zzvladyzz/Karane_SeguidorSinTurbina/Karane_Kicad/Seguidor_de_linea.kicad_pcb

## KiCad design Karane_Kicad/Seguidor_de_linea.kicad_pcb (2026-04-10)

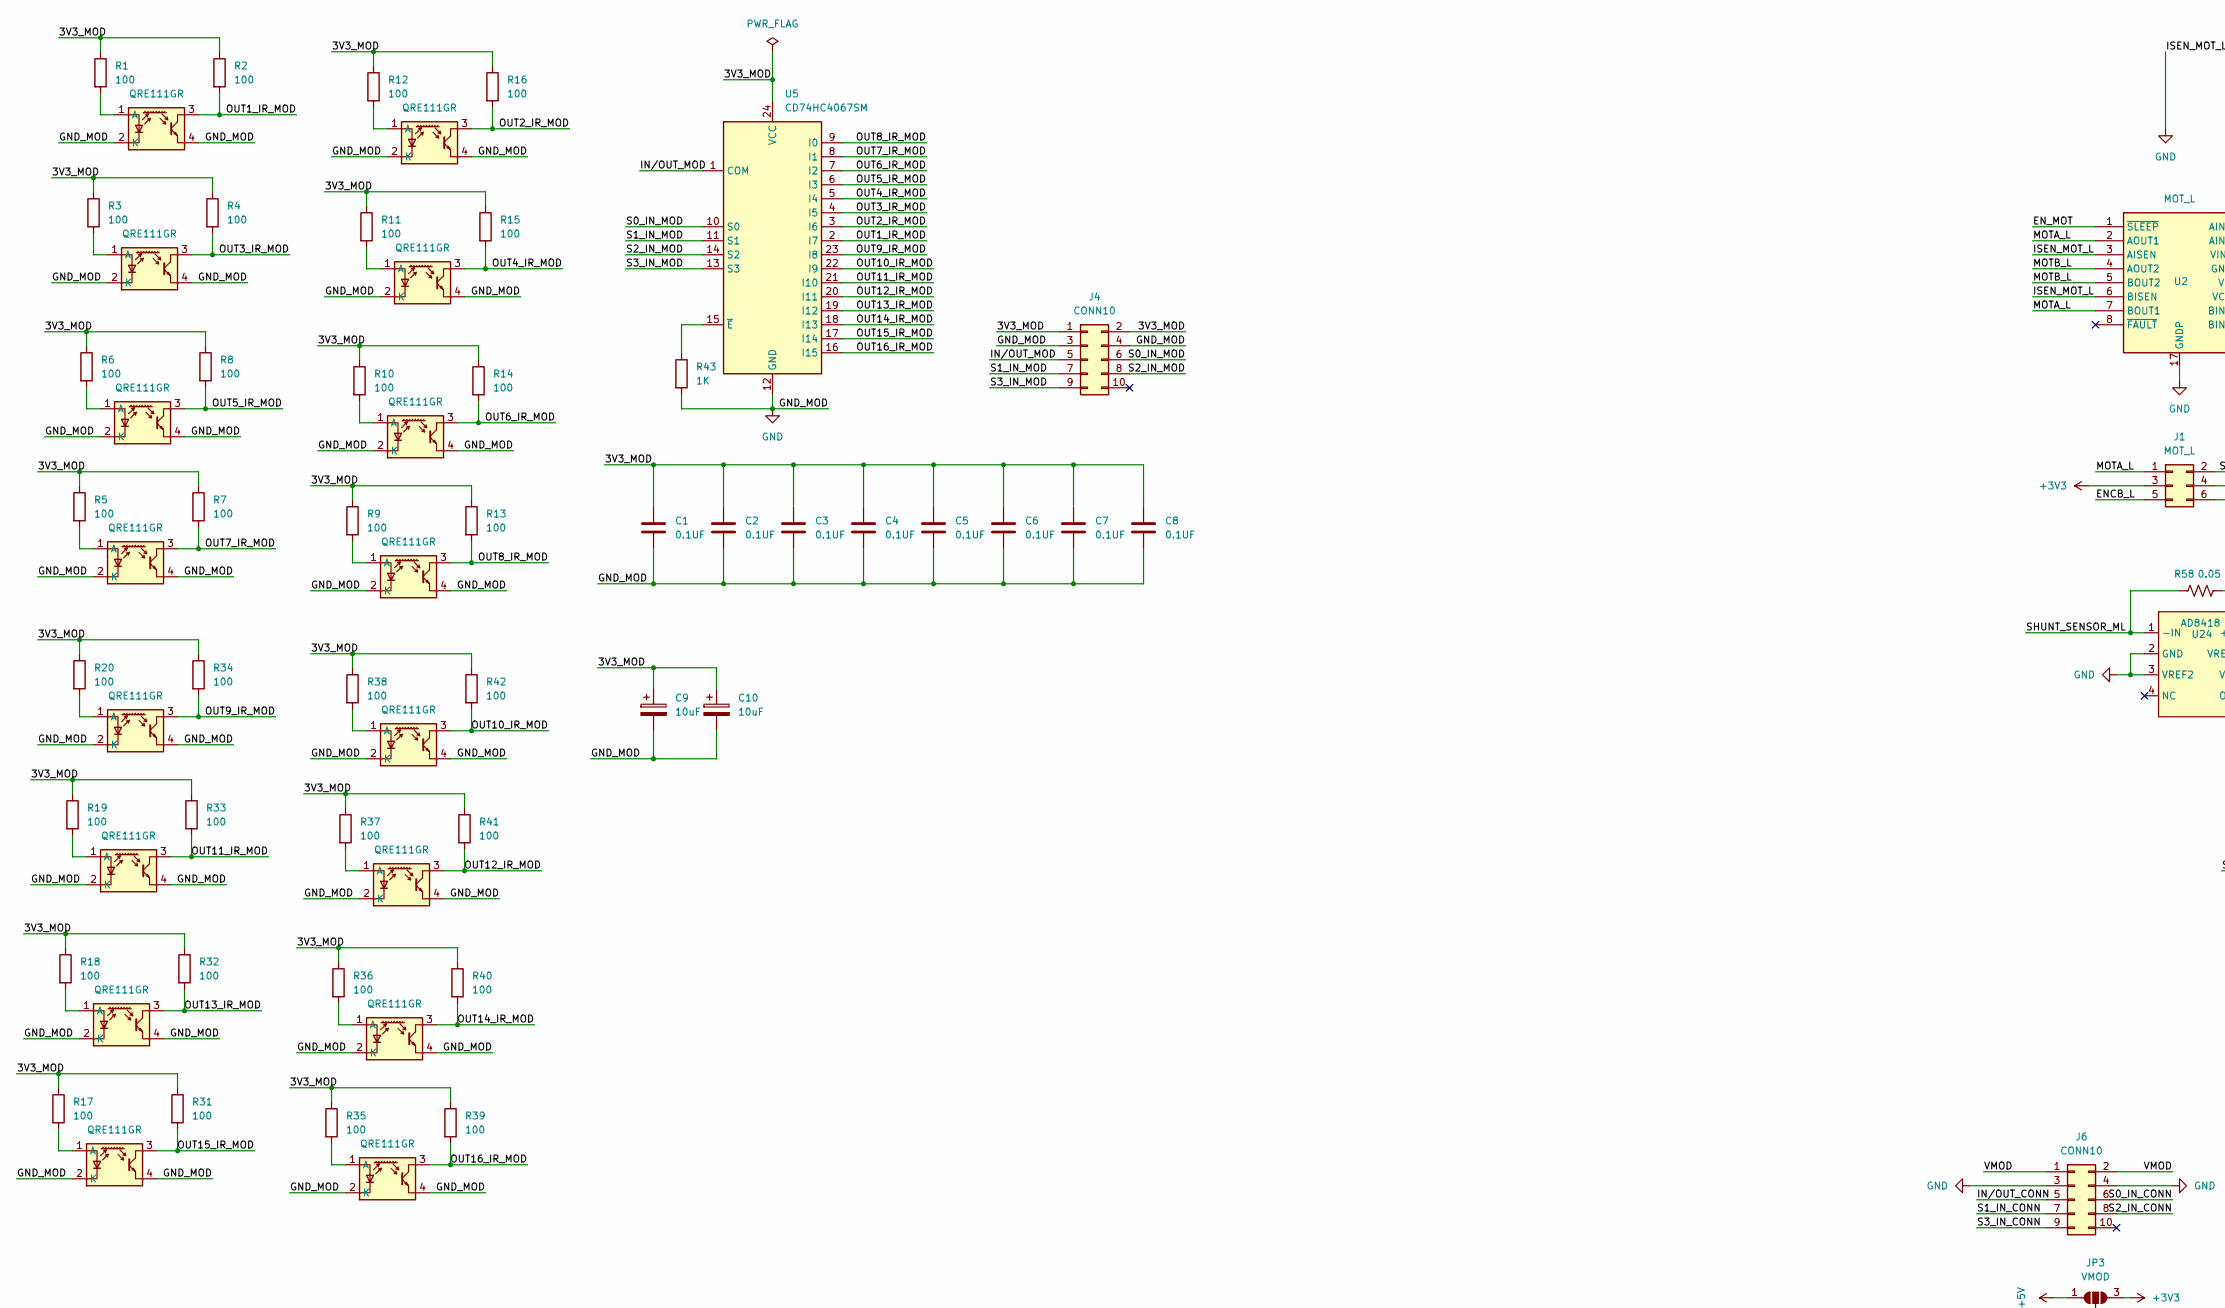
[picture p1: schematic Seguidor_de_linea.kicad_sch, Resuelve laberinto, part in row 1, column 1]

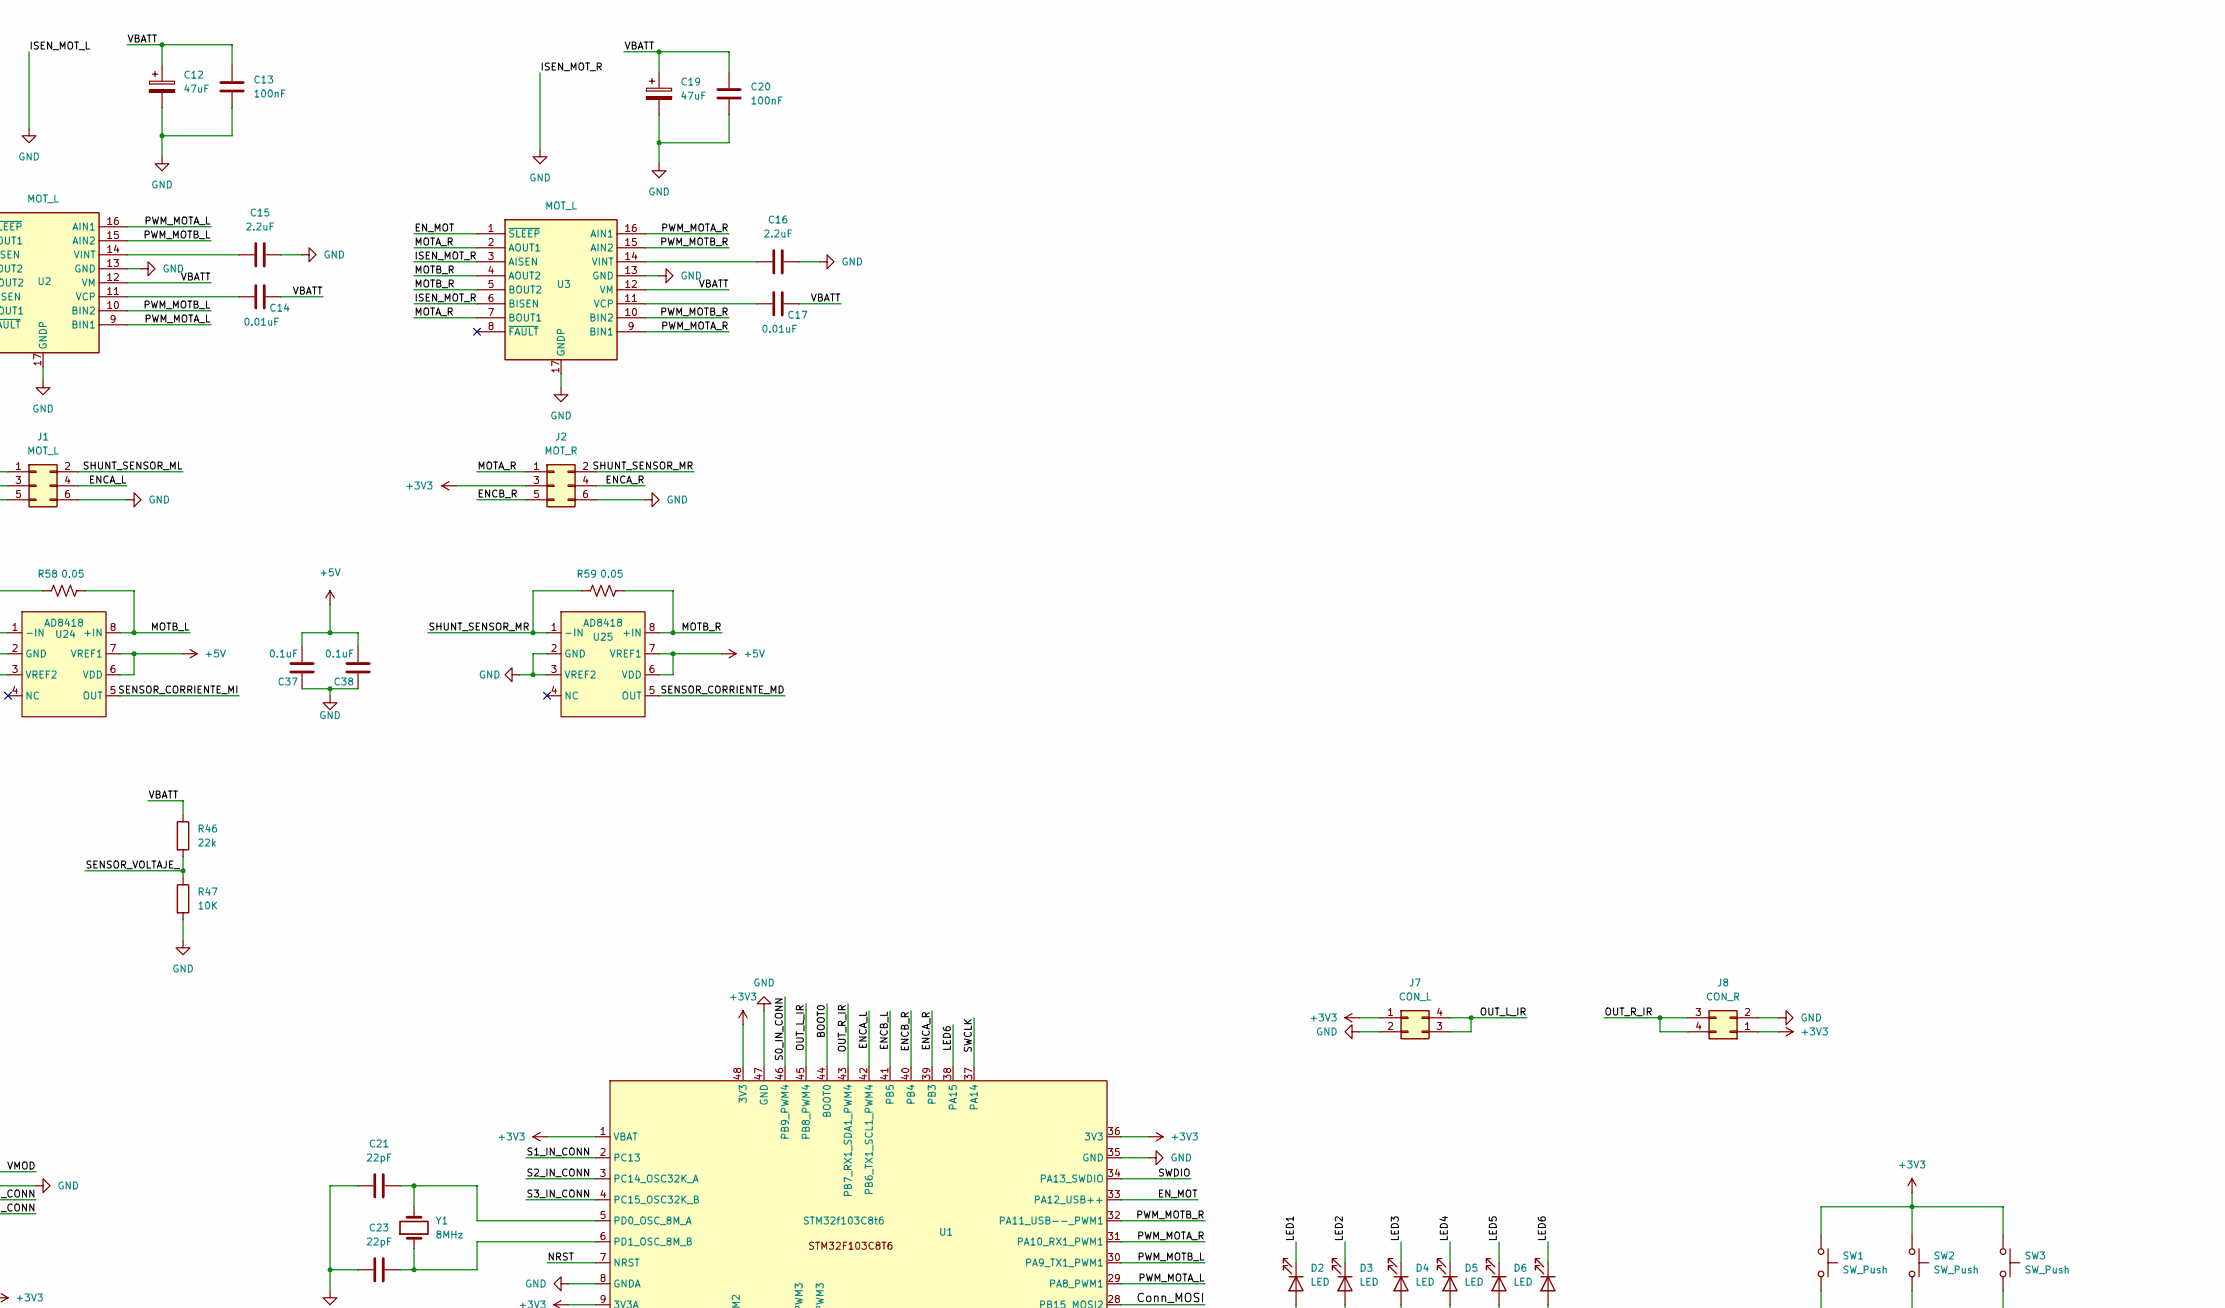
[picture p2: schematic Seguidor_de_linea.kicad_sch, Resuelve laberinto, part in row 1, column 2]

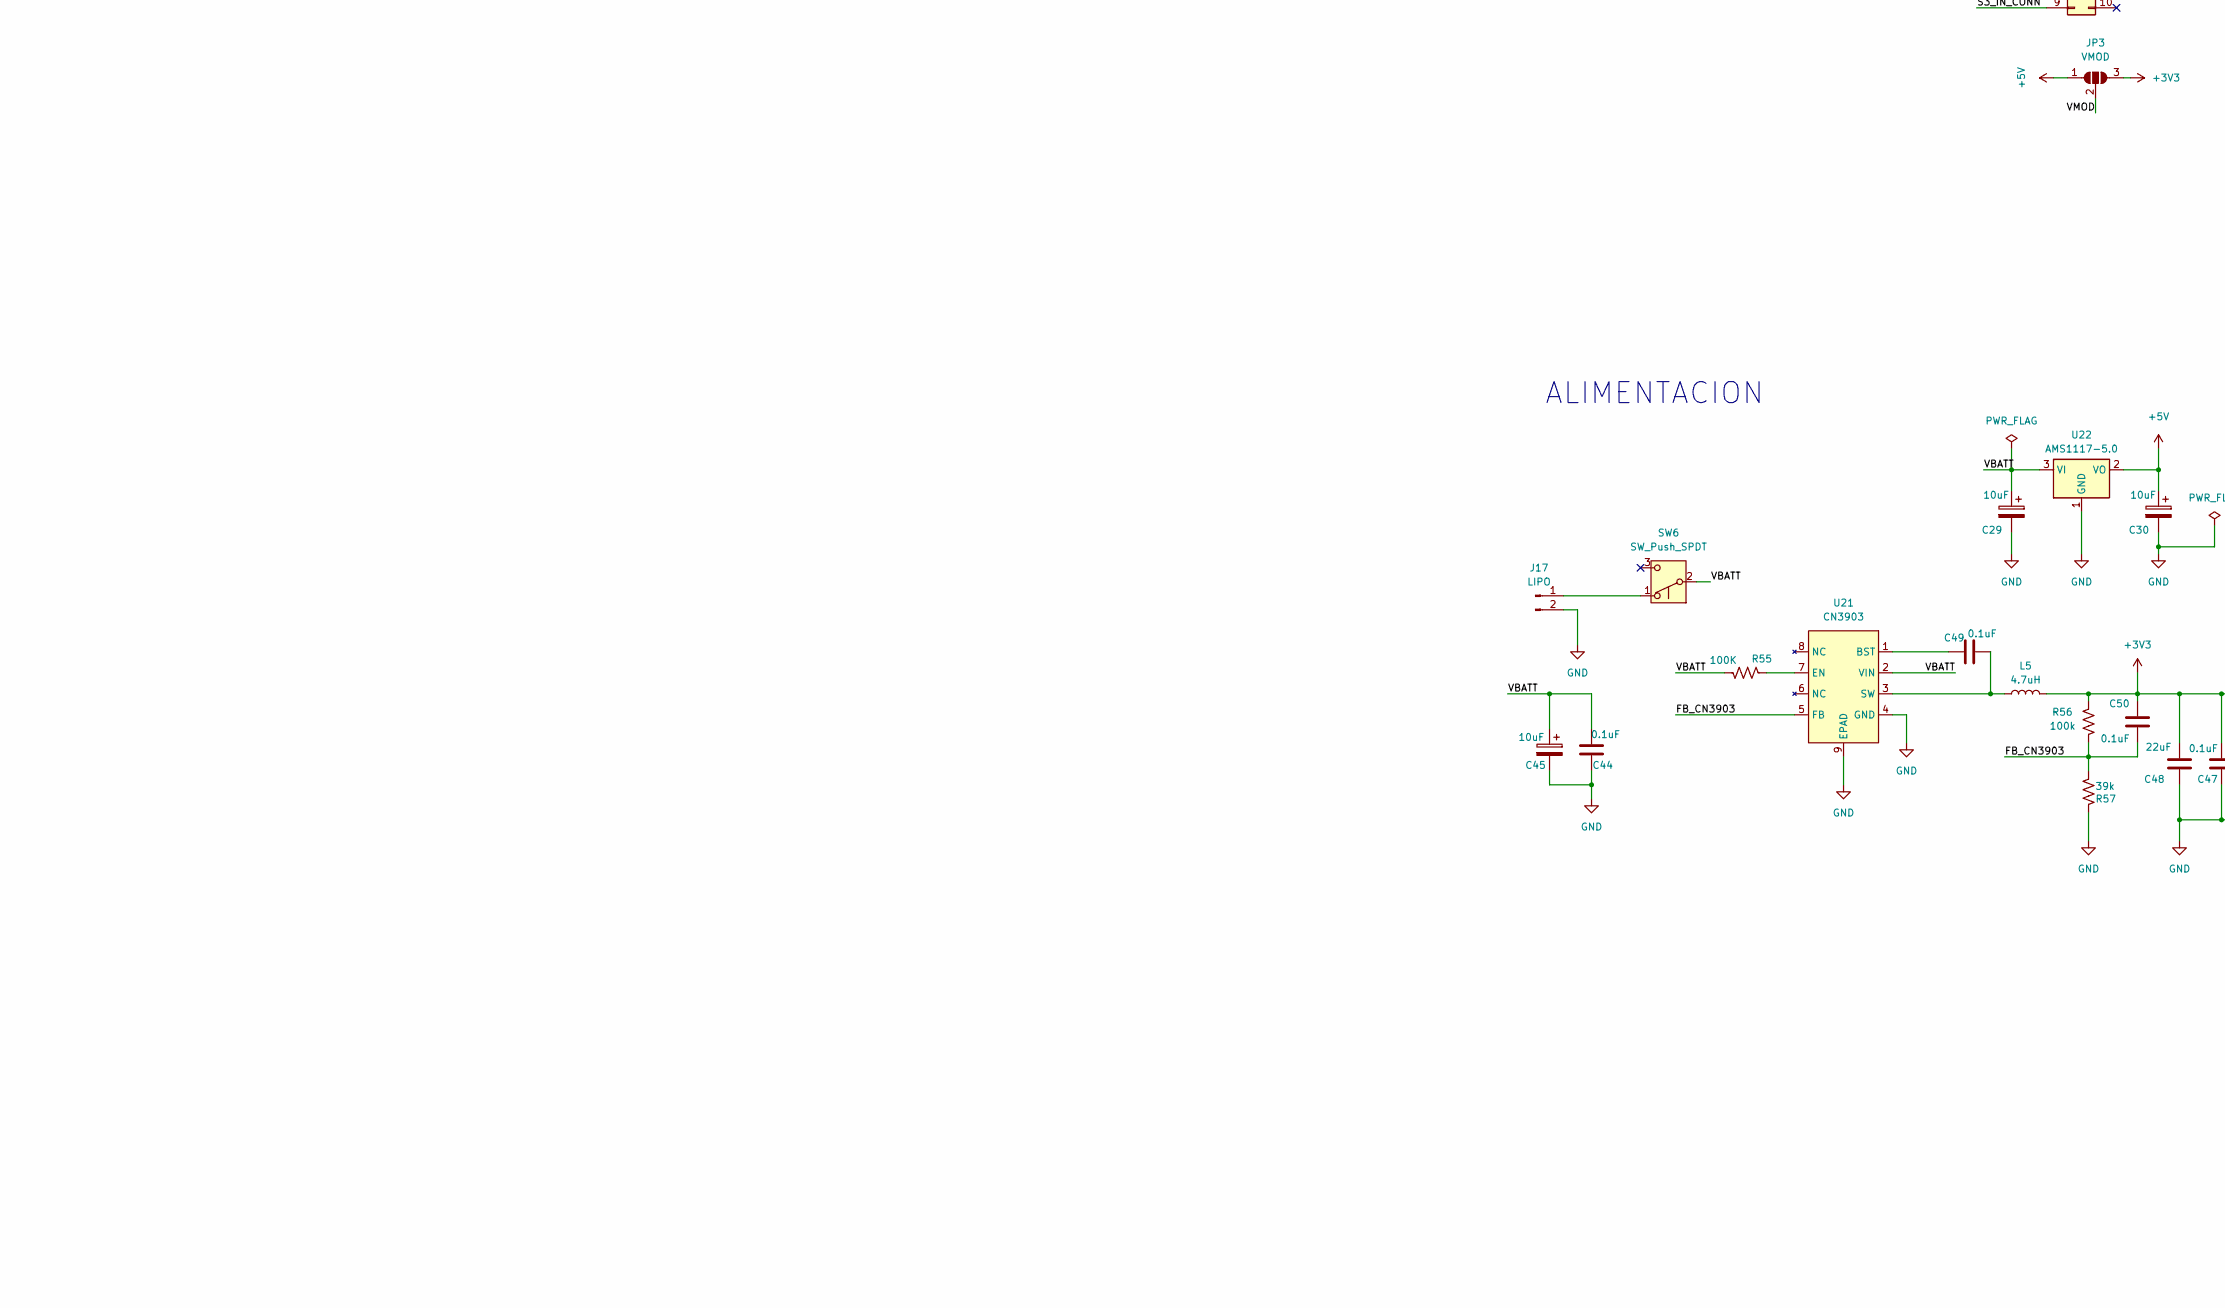
[picture p3: schematic Seguidor_de_linea.kicad_sch, Resuelve laberinto, part in row 2, column 1]

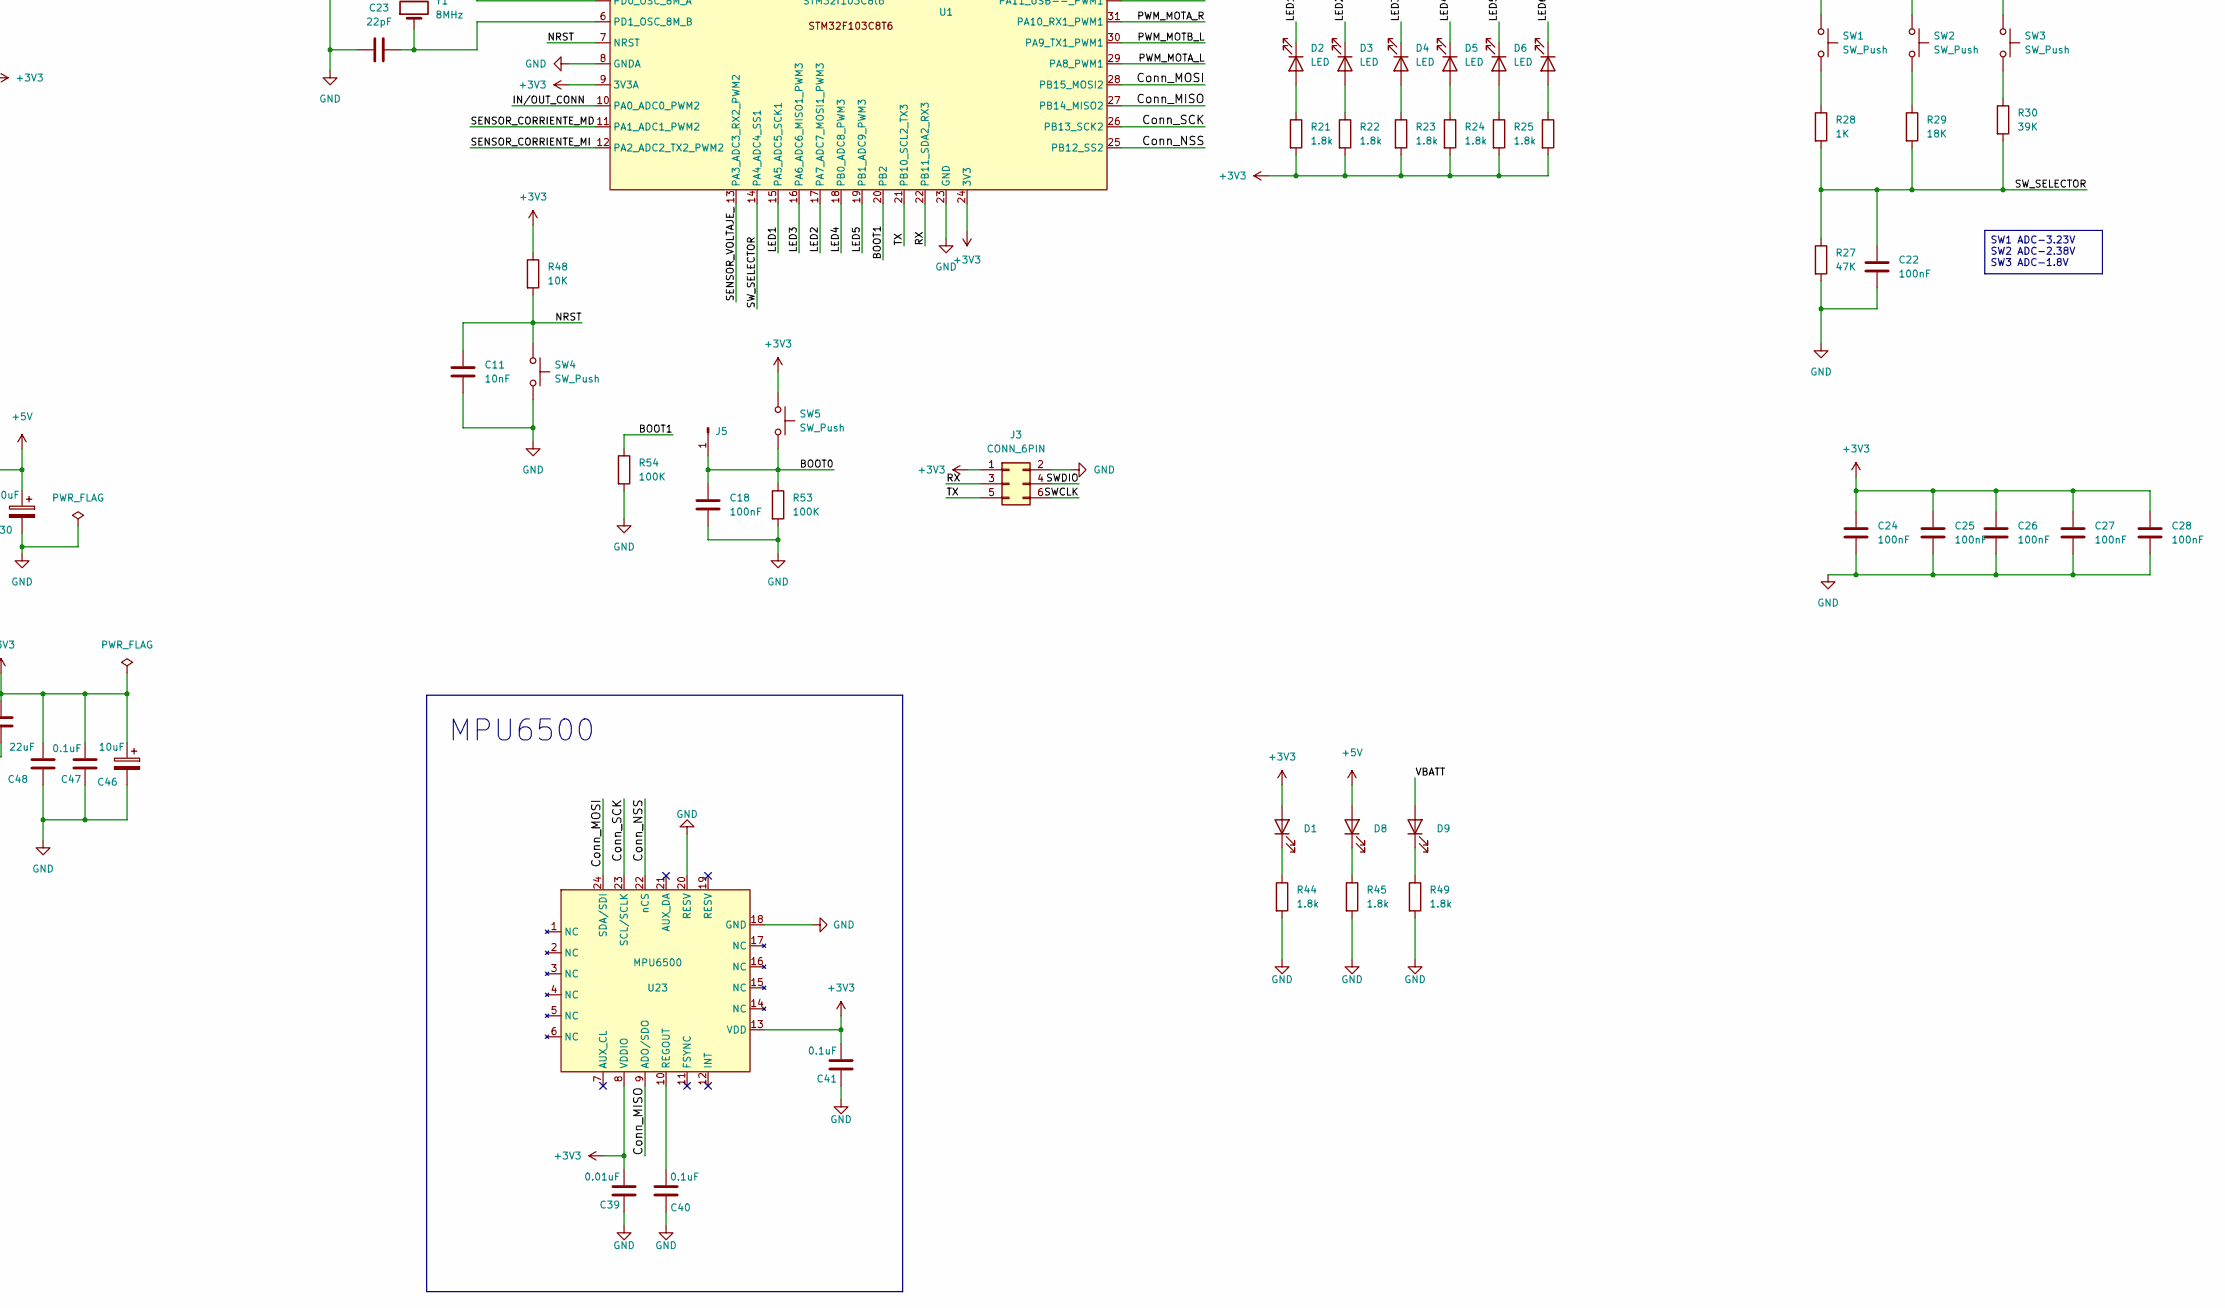
[picture p4: schematic Seguidor_de_linea.kicad_sch, Resuelve laberinto, part in row 2, column 2]

Parts:
C1, C2, C3, C4, C5, C6, C7, C8: 0.1UF; C_1206_3216Metric_Pad1.33x1.80mm_HandSolder
C9, C10: 10uF; CP_EIA-6032-15_Kemet-U_HandSolder
C11: 10nF; C_1206_3216Metric_Pad1.33x1.80mm_HandSolder
C12, C19: 47uF; C_1210_3225Metric_Pad1.33x2.70mm_HandSolder
C13, C18, C20, C22, C24, C25, C26, C27, C28: 100nF; C_1206_3216Metric_Pad1.33x1.80mm_HandSolder
C14, C17: 0.01uF; C_1206_3216Metric_Pad1.33x1.80mm_HandSolder
C15, C16: 2.2uF; C_1206_3216Metric_Pad1.33x1.80mm_HandSolder
C21, C23: 22pF; C_0805_2012Metric_Pad1.18x1.45mm_HandSolder
C29, C45, C46: 10uF; CP_Elec_4x5.4
C30: 10uF; C_1206_3216Metric_Pad1.33x1.80mm_HandSolder
C37, C38, C44, C47, C49, C50: 0.1uF; C_1206_3216Metric_Pad1.33x1.80mm_HandSolder
C39: 0.01uF; C_0805_2012Metric_Pad1.18x1.45mm_HandSolder
C40, C41: 0.1uF; C_0805_2012Metric_Pad1.18x1.45mm_HandSolder
C48: 22uF; C_1206_3216Metric_Pad1.33x1.80mm_HandSolder
D1, D2, D3, D4, D5, D6, D7, D8, D9: LED; LED_1206_3216Metric
J1: MOT_L; IDC-Header_2x03_P2.54mm_Vertical
J2: MOT_R; IDC-Header_2x03_P2.54mm_Vertical
J3: CONN_6PIN; IDC-Header_2x03_P2.54mm_Vertical
J4, J6: CONN10; IDC-Header_2x05_P2.54mm_Vertical
J5: NRST; PinHeader_1x01_P2.54mm_Vertical
J7: CON_L; PinHeader_2x02_P2.54mm_Vertical
J8: CON_R; PinHeader_2x02_P2.54mm_Vertical
J17: LIPO; PinHeader_1x02_P2.54mm_Vertical
JP3: VMOD; SolderJumper-3_P1.3mm_Open_Pad1.0x1.5mm_NumberLabels
L5: 4.7uH; L_Wuerth_HCM-7050
R1, R2, R3, R4, R5, R6, R7, R8, R9, R10, R11, R12, R13, R14, R15, R16, R17, R18, R19, R20, R31, R32, R33, R34, R35, R36, R37, R38, R39, R40, R41, R42: 100; R_1206_3216Metric_Pad1.30x1.75mm_HandSolder
R21, R22, R23, R24, R25, R26, R44, R45, R49: 1.8k; R_1206_3216Metric
R27: 47K; R_1206_3216Metric
R28, R43: 1K; R_1206_3216Metric
R29: 18K; R_1206_3216Metric
R30: 39K; R_1206_3216Metric
R46: 22k; R_1206_3216Metric
R47, R48: 10K; R_1206_3216Metric
R53, R54: 100K; R_1206_3216Metric
R55: 100K; R_0805_2012Metric_Pad1.20x1.40mm_HandSolder
R56: 100k; R_0805_2012Metric_Pad1.20x1.40mm_HandSolder
R57: 39k; R_0805_2012Metric_Pad1.20x1.40mm_HandSolder
R58, R59: 0.05; R_2512_6332Metric_Pad1.40x3.35mm_HandSolder
SW1, SW2, SW3, SW4, SW5: SW_Push; SW_SPST_CK_RS282G05A3
SW6: SW_Push_SPDT; SW_SPDT_PCM12
U1: STM32f103C8t6; LQFP-48_7x7mm_P0.5mm
U2, U3: MOT_L; HTSSOP-16-1EP_4.4x5mm_P0.65mm_EP3.4x5mm_Mask2.46x2.31mm_The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
U4, U6, U7, U8, U9, U10, U11, U12, U13, U14, U15, U16, U17, U18, U19, U20: QRE111GR; QRE1113GR_IR
U5: CD74HC4067SM; SSOP-24_5.3x8.2mm_P0.65mm
U21: CN3903; SOP-8-1EP_4.57x4.57mm_P1.27mm_EP4.57x4.45mm
U22: AMS1117-5.0; SOT-223-3_TabPin2
U23: MPU6500; InvenSense_QFN-24_3x3mm_P0.4mm
U24, U25: AD8418
Y1: 8MHz; Crystal_HC49-U_Vertical

Connections:
+3V3: C24.1, C25.1, C26.1, C27.1, C28.1, C39.2, C41.2, C46.1, C47.1, C48.1, C50.2, D1.2 (A), J1.3, J2.3, J3.1, J7.1, J8.1, JP3.3 (B), L5.1, R21.2, R22.2, R23.2, R24.2, R25.2, R26.2, R48.1, R56.1, SW1.1, SW2.1, SW3.1, SW5.1, U1.1 (VBAT), U1.9 (3V3A), U1.24 (3V3), U1.36 (3V3), U1.48 (3V3), U23.8 (VDDIO), U23.13 (VDD)
+5V: C30.1, C37.2, C38.2, D8.2 (A), JP3.1 (A), U22.2 (VO), U24.6 (VDD), U24.7 (VREF1), U25.6 (VDD), U25.7 (VREF1)
/3V3_MOD: C1.1, C2.1, C3.1, C4.1, C5.1, C6.1, C7.1, C8.1, C9.1, C10.1, J4.1, J4.2, R1.1, R2.1, R3.1, R4.1, R5.1, R6.1, R7.1, R8.1, R9.1, R10.1, R11.1, R12.1, R13.1, R14.1, R15.1, R16.1, R17.1, R18.1, R19.1, R20.1, R31.1, R32.1, R33.1, R34.1, R35.1, R36.1, R37.1, R38.1, R39.1, R40.1, R41.1, R42.1, U5.24 (VCC)
/BOOT0: C18.1, J5.1, R53.1, SW5.2, U1.44 (BOOT0)
/BOOT1: R54.1, U1.20 (PB2)
/Conn_MISO: U1.27 (PB14_MISO2), U23.9 (ADO/SDO)
/Conn_MOSI: U1.28 (PB15_MOSI2), U23.24 (SDA/SDI)
/Conn_NSS: U1.25 (PB12_SS2), U23.22 (nCS)
/Conn_SCK: U1.26 (PB13_SCK2), U23.23 (SCL/SCLK)
/ENCA_L: J1.4, U1.42 (PB6_TX1_SCL1_PWM4)
/ENCA_R: J2.4, U1.39 (PB3)
/ENCB_L: J1.5, U1.41 (PB5)
/ENCB_R: J2.5, U1.40 (PB4)
/EN_MOT: U1.33 (PA12_USB++), U2.1 (~SLEEP), U3.1 (~SLEEP)
/FB_CN3903: C50.1, R56.2, R57.1, U21.5 (FB)
/IN/OUT_CONN: J6.5, U1.10 (PA0_ADC0_PWM2)
/IN/OUT_MOD: J4.5, U5.1 (COM)
/LED1: D2.1 (K), U1.15 (PA5_ADC5_SCK1)
/LED2: D3.1 (K), U1.17 (PA7_ADC7_MOSI1_PWM3)
/LED3: D4.1 (K), U1.16 (PA6_ADC6_MISO1_PWM3)
/LED4: D5.1 (K), U1.18 (PB0_ADC8_PWM3)
/LED5: D6.1 (K), U1.19 (PB1_ADC9_PWM3)
/LED6: D7.1 (K), U1.38 (PA15)
/MOTA_L: J1.1, U2.2 (AOUT1), U2.7 (BOUT1)
/MOTA_R: J2.1, U3.2 (AOUT1), U3.7 (BOUT1)
/MOTB_L: R58.2, U2.4 (AOUT2), U2.5 (BOUT2), U24.8 (+IN)
/MOTB_R: R59.2, U3.4 (AOUT2), U3.5 (BOUT2), U25.8 (+IN)
/NRST: C11.1, R48.2, SW4.1, U1.7 (NRST)
/OUT1_IR_MOD: R2.2, U4.3, U5.2 (I7)
/OUT2_IR_MOD: R16.2, U5.3 (I6), U12.3
/OUT3_IR_MOD: R4.2, U5.4 (I5), U6.3
/OUT4_IR_MOD: R15.2, U5.5 (I4), U11.3
/OUT5_IR_MOD: R8.2, U5.6 (I3), U8.3
/OUT6_IR_MOD: R14.2, U5.7 (I2), U10.3
/OUT7_IR_MOD: R7.2, U5.8 (I1), U7.3
/OUT8_IR_MOD: R13.2, U5.9 (I0), U9.3
/OUT9_IR_MOD: R34.2, U5.23 (I8), U16.3
/OUT10_IR_MOD: R42.2, U5.22 (I9), U20.3
/OUT11_IR_MOD: R33.2, U5.21 (I10), U15.3
/OUT12_IR_MOD: R41.2, U5.20 (I11), U19.3
/OUT13_IR_MOD: R32.2, U5.19 (I12), U14.3
/OUT14_IR_MOD: R40.2, U5.18 (I13), U18.3
/OUT15_IR_MOD: R31.2, U5.17 (I14), U13.3
/OUT16_IR_MOD: R39.2, U5.16 (I15), U17.3
/OUT_L_IR: J7.3, J7.4, U1.45 (PB8_PWM4)
/OUT_R_IR: J8.3, J8.4, U1.43 (PB7_RX1_SDA1_PWM4)
/PWM_MOTA_L: U1.29 (PA8_PWM1), U2.9 (BIN1), U2.16 (AIN1)
/PWM_MOTA_R: U1.31 (PA10_RX1_PWM1), U3.9 (BIN1), U3.16 (AIN1)
/PWM_MOTB_L: U1.30 (PA9_TX1_PWM1), U2.10 (BIN2), U2.15 (AIN2)
/PWM_MOTB_R: U1.32 (PA11_USB--_PWM1), U3.10 (BIN2), U3.15 (AIN2)
/RX: J3.3, U1.22 (PB11_SDA2_RX3)
/S0_IN_CONN: J6.6, U1.46 (PB9_PWM4)
/S0_IN_MOD: J4.6, U5.10 (S0)
/S1_IN_CONN: J6.7, U1.2 (PC13)
/S1_IN_MOD: J4.7, U5.11 (S1)
/S2_IN_CONN: J6.8, U1.3 (PC14_OSC32K_A)
/S2_IN_MOD: J4.8, U5.14 (S2)
/S3_IN_CONN: J6.9, U1.4 (PC15_OSC32K_B)
/S3_IN_MOD: J4.9, U5.13 (S3)
/SENSOR_CORRIENTE_MD: U1.11 (PA1_ADC1_PWM2), U25.5 (OUT)
/SENSOR_CORRIENTE_MI: U1.12 (PA2_ADC2_TX2_PWM2), U24.5 (OUT)
/SENSOR_VOLTAJE_: R46.2, R47.1, U1.13 (PA3_ADC3_RX2_PWM2)
/SHUNT_SENSOR_ML: J1.2, R58.1, U24.1 (-IN)
/SHUNT_SENSOR_MR: J2.2, R59.1, U25.1 (-IN)
/SWCLK: J3.6, U1.37 (PA14)
/SWDIO: J3.4, U1.34 (PA13_SWDIO)
/SW_SELECTOR: C22.1, R27.1, R28.2, R29.2, R30.2, U1.14 (PA4_ADC4_SS1)
/TX: J3.5, U1.21 (PB10_SCL2_TX3)
/VBATT: C12.1, C13.1, C14.2, C17.2, C19.1, C20.1, C29.1, C44.1, C45.1, D9.2 (A), R46.1, R55.2, SW6.2 (B), U2.12 (VM), U3.12 (VM), U21.2 (VIN), U22.3 (VI)
/VMOD: J6.1, J6.2, JP3.2 (C)
GND: C1.2, C2.2, C3.2, C4.2, C5.2, C6.2, C7.2, C8.2, C9.2, C10.2, C11.2, C12.2, C13.2, C15.2, C16.2, C18.2, C19.2, C20.2, C21.1, C22.2, C23.2, C24.2, C25.2, C26.2, C27.2, C28.2, C29.2, C30.2, C37.1, C38.1, C39.1, C40.1, C41.1, C44.2, C45.2, C46.2, C47.2, C48.2, J1.6, J2.6, J3.2, J4.3, J4.4, J6.3, J6.4, J7.2, J8.2, J17.2, R27.2, R43.2, R44.2, R45.2, R47.2, R49.2, R53.2, R54.2, R57.2, SW4.2, U1.8 (GNDA), U1.23 (GND), U1.35 (GND), U1.47 (GND), U2.3 (AISEN), U2.6 (BISEN), U2.13 (GND), U2.17 (GNDP), U3.3 (AISEN), U3.6 (BISEN), U3.13 (GND), U3.17 (GNDP), U4.2 (K), U4.4, U5.12 (GND), U6.2 (K), U6.4, U7.2 (K), U7.4, U8.2 (K), U8.4, U9.2 (K), U9.4, U10.2 (K), U10.4, U11.2 (K), U11.4, U12.2 (K), U12.4, U13.2 (K), U13.4, U14.2 (K), U14.4, U15.2 (K), U15.4, U16.2 (K), U16.4, U17.2 (K), U17.4, U18.2 (K), U18.4, U19.2 (K), U19.4, U20.2 (K), U20.4, U21.4 (GND), U21.9 (EPAD), U22.1 (GND), U23.18 (GND), U23.20 (RESV), U24.2 (GND), U24.3 (VREF2), U25.2 (GND), U25.3 (VREF2)
unnamed: D1.1 (K), R44.1
unnamed: D2.2 (A), R21.1
unnamed: D3.2 (A), R22.1
unnamed: D4.2 (A), R23.1
unnamed: D5.2 (A), R24.1
unnamed: D6.2 (A), R25.1
unnamed: D7.2 (A), R26.1
unnamed: D8.1 (K), R45.1
unnamed: D9.1 (K), R49.1
unnamed: J17.1, SW6.1 (A)
unnamed: R28.1, SW1.2
unnamed: R29.1, SW2.2
unnamed: R30.1, SW3.2
unnamed: C21.2, U1.5 (PD0_OSC_8M_A), Y1.2
unnamed: C23.1, U1.6 (PD1_OSC_8M_B), Y1.1
unnamed: C14.1, U2.11 (VCP)
unnamed: C15.1, U2.14 (VINT)
unnamed: C17.1, U3.11 (VCP)
unnamed: C16.1, U3.14 (VINT)
unnamed: R1.2, U4.1 (A)
unnamed: R43.1, U5.15 (~E)
unnamed: R3.2, U6.1 (A)
unnamed: R5.2, U7.1 (A)
unnamed: R6.2, U8.1 (A)
unnamed: R9.2, U9.1 (A)
unnamed: R10.2, U10.1 (A)
unnamed: R11.2, U11.1 (A)
unnamed: R12.2, U12.1 (A)
unnamed: R17.2, U13.1 (A)
unnamed: R18.2, U14.1 (A)
unnamed: R19.2, U15.1 (A)
unnamed: R20.2, U16.1 (A)
unnamed: R35.2, U17.1 (A)
unnamed: R36.2, U18.1 (A)
unnamed: R37.2, U19.1 (A)
unnamed: R38.2, U20.1 (A)
unnamed: C49.2, U21.1 (BST)
unnamed: R55.1, U21.7 (EN)
unnamed: C49.1, L5.2, U21.3 (SW)
unnamed: C40.2, U23.10 (REGOUT)

Notes on the sheet:
MPU6500
ALIMENTACION
SW1 ADC-3.23V SW2 ADC-2.38V SW3 ADC-1.8V

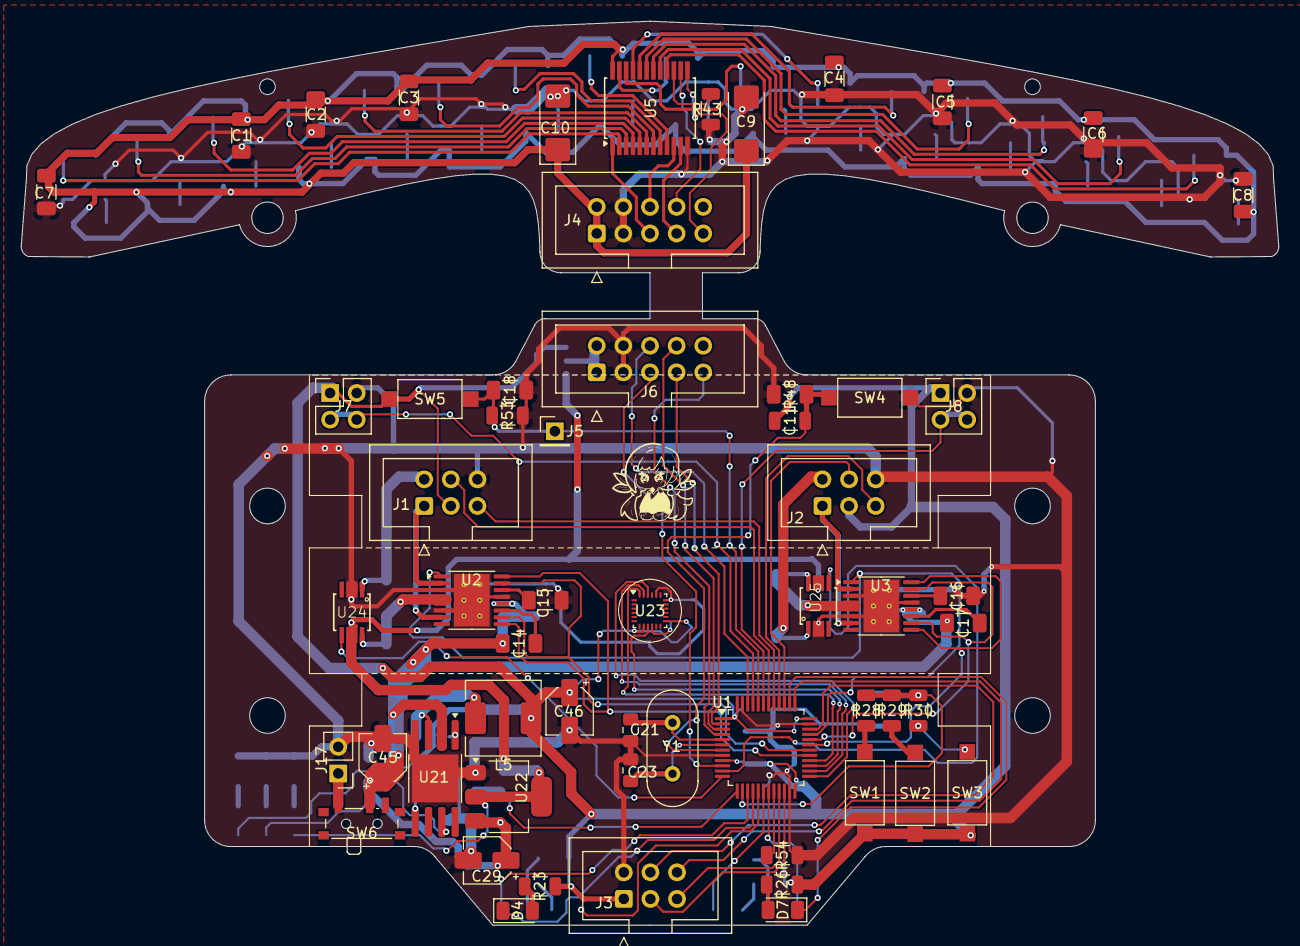
[picture p5: board Seguidor_de_linea.kicad_pcb from above]

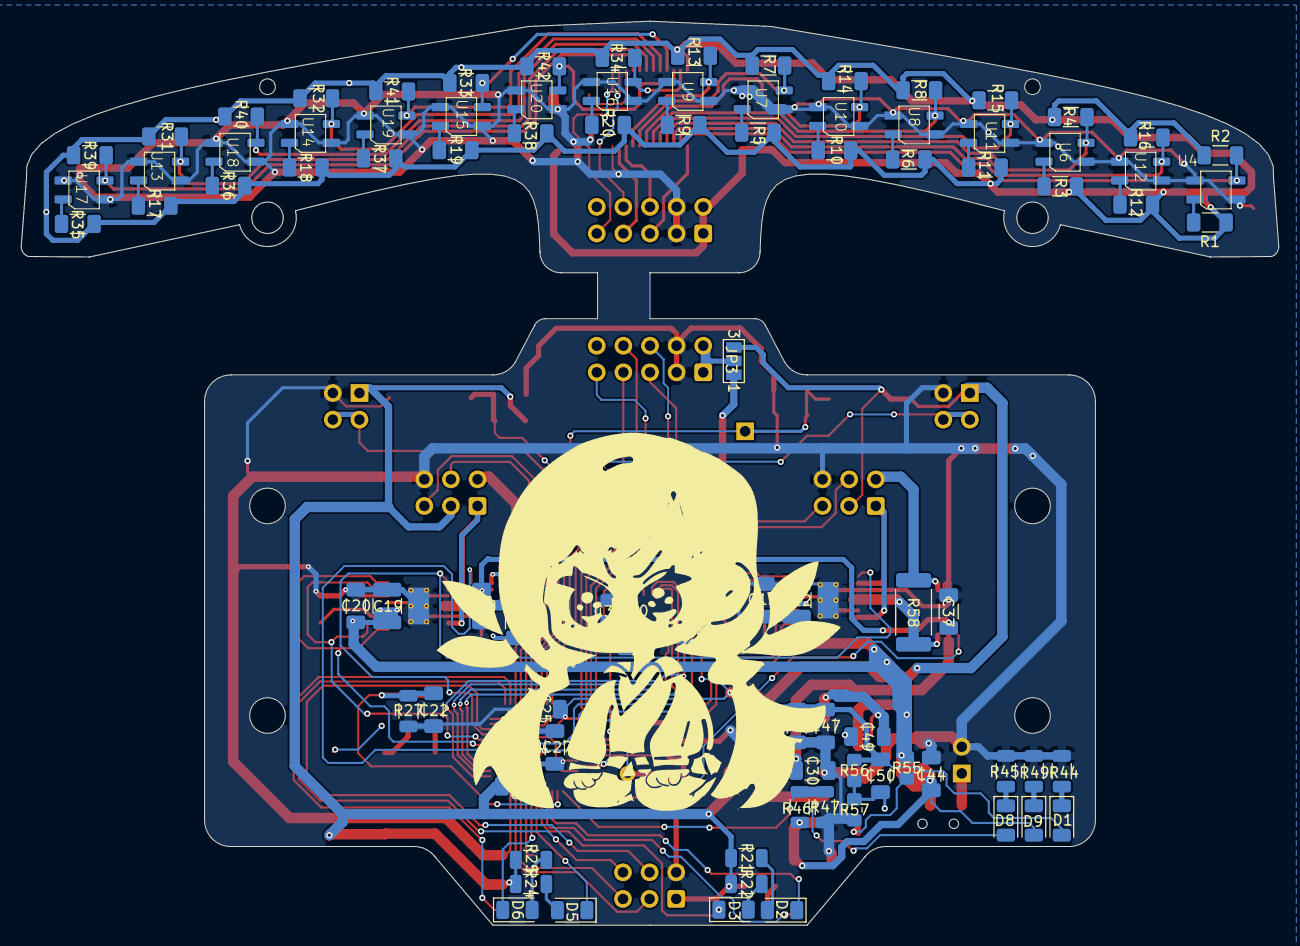
[picture p6: board Seguidor_de_linea.kicad_pcb from below]

Board: 2 copper layers, 120.0 x 86.3 mm, 152 parts (93 on the bottom side), 111 nets.

Other parts of the board:
., .#2: LOGO
