zzvladyzz/Karane_SeguidorSinTurbina/Karane_STM32/Karane_STM32.ioc

Mcu.UserName=STM32F103C8Tx
PA0-WKUP.GPIO_Label=IN_mux
PA0-WKUP.Signal=ADCx_IN0
PA1.GPIO_Label=SensorAmp_MD
PA1.Signal=ADCx_IN1
PA10.GPIO_Label=PWM_MOTA_R
PA10.Signal=S_TIM1_CH3
PA11.GPIO_Label=PWM_MOTB_R
PA11.Signal=S_TIM1_CH4
PA12.GPIO_Label=EN_MOT
PA12.Signal=GPIO_Output
PA13.Signal=SYS_JTMS-SWDIO
PA14.Signal=SYS_JTCK-SWCLK
PA15.GPIO_Label=LED6
PA15.Signal=GPIO_Output
PA2.GPIO_Label=SensorAmp_MI
PA2.Signal=ADCx_IN2
PA3.GPIO_Label=Sensor_Voltaje
PA3.Signal=ADCx_IN3
PA4.GPIO_Label=SW_Selector
PA4.Signal=ADCx_IN4
PA5.GPIO_Label=LED1
PA5.Signal=GPIO_Output
PA6.GPIO_Label=LED3
PA6.Signal=GPIO_Output
PA7.GPIO_Label=LED2
PA7.Signal=GPIO_Output
PA8.GPIO_Label=PWM_MOTA_L
PA8.Signal=S_TIM1_CH1
PA9.GPIO_Label=PWM_MOTB_L
PA9.Signal=S_TIM1_CH2
PB0.GPIO_Label=LED4
PB0.Signal=GPIO_Output
PB1.GPIO_Label=LED5
PB1.Signal=GPIO_Output
PB10.Signal=USART3_TX
PB11.Signal=USART3_RX
PB12.GPIO_Label=SPI_NSS
PB12.Signal=GPIO_Output
PB13.Signal=SPI2_SCK
PB14.Signal=SPI2_MISO
PB15.Signal=SPI2_MOSI
PB2.GPIO_Label=BOOT1
PB2.Signal=GPIO_Output
PB3.GPIO_Label=ENCA_R
PB3.Signal=GPXTI3
PB4.GPIO_Label=ENCB_R
PB4.Signal=GPXTI4
PB5.GPIO_Label=ENCB_L
PB5.Signal=GPXTI5
PB6.GPIO_Label=ENCA_L
PB6.Signal=GPXTI6
PB7.GPIO_Label=IR_R_IN
PB7.Signal=GPIO_Input
PB8.GPIO_Label=IR_L_IN
PB8.Signal=GPIO_Input
PB9.GPIO_Label=S0_mux
PB9.Signal=GPIO_Output
PC13-TAMPER-RTC.GPIO_Label=S1_mux
PC13-TAMPER-RTC.Signal=GPIO_Output
PC14-OSC32_IN.GPIO_Label=S2_mux
PC14-OSC32_IN.Signal=GPIO_Output
PC15-OSC32_OUT.GPIO_Label=S3_mux
PC15-OSC32_OUT.Signal=GPIO_Output
PD0-OSC_IN.Signal=RCC_OSC_IN
PD1-OSC_OUT.Signal=RCC_OSC_OUT
