zzvladyzz/Karane_SeguidorSinTurbina/Karane_STM32/Core/Inc/main.h

#define S1_mux_Pin GPIO_PIN_13
#define S1_mux_GPIO_Port GPIOC
#define S2_mux_Pin GPIO_PIN_14
#define S2_mux_GPIO_Port GPIOC
#define S3_mux_Pin GPIO_PIN_15
#define S3_mux_GPIO_Port GPIOC
#define IN_mux_Pin GPIO_PIN_0
#define IN_mux_GPIO_Port GPIOA
#define SensorAmp_MD_Pin GPIO_PIN_1
#define SensorAmp_MD_GPIO_Port GPIOA
#define SensorAmp_MI_Pin GPIO_PIN_2
#define SensorAmp_MI_GPIO_Port GPIOA
#define Sensor_Voltaje_Pin GPIO_PIN_3
#define Sensor_Voltaje_GPIO_Port GPIOA
#define SW_Selector_Pin GPIO_PIN_4
#define SW_Selector_GPIO_Port GPIOA
#define LED1_Pin GPIO_PIN_5
#define LED1_GPIO_Port GPIOA
#define LED3_Pin GPIO_PIN_6
#define LED3_GPIO_Port GPIOA
#define LED2_Pin GPIO_PIN_7
#define LED2_GPIO_Port GPIOA
#define LED4_Pin GPIO_PIN_0
#define LED4_GPIO_Port GPIOB
#define LED5_Pin GPIO_PIN_1
#define LED5_GPIO_Port GPIOB
#define BOOT1_Pin GPIO_PIN_2
#define BOOT1_GPIO_Port GPIOB
#define SPI_NSS_Pin GPIO_PIN_12
#define SPI_NSS_GPIO_Port GPIOB
#define PWM_MOTA_L_Pin GPIO_PIN_8
#define PWM_MOTA_L_GPIO_Port GPIOA
#define PWM_MOTB_L_Pin GPIO_PIN_9
#define PWM_MOTB_L_GPIO_Port GPIOA
#define PWM_MOTA_R_Pin GPIO_PIN_10
#define PWM_MOTA_R_GPIO_Port GPIOA
#define PWM_MOTB_R_Pin GPIO_PIN_11
#define PWM_MOTB_R_GPIO_Port GPIOA
#define EN_MOT_Pin GPIO_PIN_12
#define EN_MOT_GPIO_Port GPIOA
#define LED6_Pin GPIO_PIN_15
#define LED6_GPIO_Port GPIOA
#define ENCA_R_Pin GPIO_PIN_3
#define ENCA_R_GPIO_Port GPIOB
#define ENCA_R_EXTI_IRQn EXTI3_IRQn
#define ENCB_R_Pin GPIO_PIN_4
#define ENCB_R_GPIO_Port GPIOB
#define ENCB_R_EXTI_IRQn EXTI4_IRQn
#define ENCB_L_Pin GPIO_PIN_5
#define ENCB_L_GPIO_Port GPIOB
#define ENCB_L_EXTI_IRQn EXTI9_5_IRQn
#define ENCA_L_Pin GPIO_PIN_6
#define ENCA_L_GPIO_Port GPIOB
#define ENCA_L_EXTI_IRQn EXTI9_5_IRQn
#define IR_R_IN_Pin GPIO_PIN_7
#define IR_R_IN_GPIO_Port GPIOB
#define IR_L_IN_Pin GPIO_PIN_8
#define IR_L_IN_GPIO_Port GPIOB
#define S0_mux_Pin GPIO_PIN_9
#define S0_mux_GPIO_Port GPIOB
