zzvladyzz/Karane_SeguidorSinTurbina/Karane_STM32/Core/Inc/LIB_MENU.h

/*
 * LIB_LED_INDA.h
 *
 *  Created on: Dec 13, 2025
 *      Author: Vlady-Chuwi
 */

#ifndef INC_LIB_MENU_H_
#define INC_LIB_MENU_H_

#include <stdint.h>
#include <stdbool.h>

#define BTN_DERECHA		1
#define BTN_IZQUIERDA	2
#define BTN_ACEPTAR		3

/**
 *	@brief 	Estructura para definir retardos dentro de los menus si se necesita
 */
typedef struct{
	uint32_t tiempo_de_espera;
	bool espera;
	uint8_t estado_interno;
}Tiempo_espera_s;

/**
 *	@brief 	Estructura para definir los menus y realizar ajustes o ejecutar el programa
 */
typedef enum{
	Menu_Inicial=0,
	Opcion_Configuracion_PID_1,
	Opcion_Configuracion_PID_2,
	Opcion_Configuracion_PID_3,
	Opcion_Calibracion_Sensores,
	Opcion_Monitoreo,
	Opcion_Iniciar_CodigoA,
	Menu_Final
}Menu_Parametros_e;

/**
 *	@brief 	Estructura para generar estados o avisos segun la necesidad
 */
typedef enum{
	Estado_BTN_derecha,
	Estado_BTN_izquierda,
	Estado_BTN_ok,
	Estado_BTN_salir,
	Aviso_fallo,
	Aviso_ok,
	Aviso_bateria_baja,
	Apagar_LED,
}Indicador_LED_e;

extern Indicador_LED_e	indicadorLED;
extern Menu_Parametros_e 	Menu_Global;
void	Tiempo_Espera(void);
uint8_t	Menu_Navegacion(uint8_t BTN);
bool	Menu_Ejecucion(void);
void	Menu_ubicacion(Menu_Parametros_e menu);
void	Menu_aviso(Indicador_LED_e LED);

#endif /* INC_LIB_MENU_H_ */
