zzvladyzz/Karane_SeguidorSinTurbina/(commit log)

2026-03-26 Proyecto unido Hardware y Software
    [Seguidor_de_linea.kicad_pcb, Seguidor_de_linea.kicad_sch]
2026-03-26 Ahora deberia incluir la carpeta de stm32
    [Karane_STM32.cfg]
2026-04-10 mejora de lectura de sensores
    [Karane_Kicad.kicad_pcb, Karane_Kicad.kicad_sch, Karane_STM32.cfg]
2026-04-10 velocidad a 300 por probar en pista grande
2026-05-02 Se mejoro el MPU6500 por errores
    [Karane_STM32.ioc, LIB_DEBUG.c, LIB_DEBUG.h, LIB_MPU6500_SPI.c, LIB_MPU6500_SPI.h, main.c]
2026-05-03 Codigo corregido y eliminado varias funciones revisar menu para ver si quitar cosas
2026-05-04 Corregido PID y funcionando, borrar demas logica de encoders para no generar problemas de mando
    [LIB_DEBUG.c, LIB_DEBUG.h, LIB_MPU6500_SPI.c, LIB_Motores.c, LIB_funciones.c, LIB_funciones.h, main.c]
2026-05-07 probado pid
